maolin2501/A3/el_a3_sdk/README.md

# EL-A3 Python SDK

> 7-DOF 桌面机械臂纯 Python SDK，基于 Direct CAN 通信，支持多臂管理、Pinocchio 动力学、S-curve 轨迹规划。

---

## 文档

| 语言 | 文件 |
|---|---|
| 中文 | [README_zh.md](README_zh.md) |
| English | [README_en.md](README_en.md) |

---

## 快速开始

```bash
# 安装 SDK（开发模式）
cd el_a3_sdk
pip install -e .

# 如需运动学/动力学功能
pip install -e ".[dynamics]"

# 配置 CAN 接口
sudo bash scripts/setup_can.sh can0 1000000

# 运行示例
python3 demo/control_loop_demo.py
python3 demo/zero_torque_mode.py --gravity
```

---

## 项目结构

| 目录/文件 | 说明 |
|---|---|
| `el_a3_sdk/` | Python 包核心代码 |
| `demo/` | 示例脚本 |
| `docs/` | SDK API 协议文档 |
| `resources/` | URDF、Meshes、惯性参数配置 |
| `scripts/` | CAN 配置、测试脚本 |
| `setup.py` | pip 安装配置 |

---

## 依赖

- **必需**: `numpy`, `pyyaml`
- **可选**: `pin` (Pinocchio) - 运动学/动力学

---

## 示例

| 示例 | 说明 |
|---|---|
| `control_loop_demo.py` | 200Hz 控制循环、MoveJ、JointCtrl |
| `xbox_control.py` | Xbox 手柄笛卡尔控制 |
| `zero_torque_mode.py` | 零力矩拖动模式 |
| `dynamics_demo.py` | 重力补偿、雅可比、质量矩阵 |
| `trajectory_demo.py` | S-curve 和样条轨迹规划 |
| `cartesian_control_demo.py` | 笛卡尔空间控制 |
| `motion_control.py` | 路径点运动控制 |
| `waypoint_loop_real.py` | 路径点循环测试 |
| `read_joints.py` | 关节状态读取 |
