maolin2501/A3/el_a3_ros/EDULITE-A3/README.md

# EDULITE-A3

原始 URDF 导出模型文件（PART/STL），供参考使用。

详见项目根目录 [README](../README.md)。
