maolin2501/A3/el_a3_ros/EL_A3_urdf/README.md

# EL_A3_urdf

早期 URDF 版本文件，供参考使用。

当前版本请使用 `el_a3_description/urdf/` 下的 URDF 文件。
