maolin2501/A3/(list of files, cad)

Other CAD files:
el_a3_ros/EL_A3_urdf/EL-A3/meshes/mainlink_back.stl
el_a3_sdk/resources/meshes/mainlink_back.stl
el_a3_sdk/resources/meshes/mainlink_motor.stl
el_a3_ros/EDULITE-A3/meshes/mainlink_motor.stl
el_a3_ros/el_a3_description/meshes/mainlink_motor.stl
el_a3_ros/EL_A3_urdf/EL-A3/meshes/mainlink_motor.stl
el_a3_ros/EDULITE-A3/meshes/mainlink_back.stl
el_a3_ros/el_a3_description/meshes/mainlink_back.stl
el_a3_ros/EDULITE-A3/meshes/l4_l5_link_back.stl
el_a3_ros/el_a3_description/meshes/rack__30_teeth__2.stl
hardware/step/Edulite_A3.step
el_a3_ros/EDULITE-A3/meshes/part_9.stl
el_a3_ros/el_a3_description/meshes/rack_base.stl
el_a3_ros/EL_A3_urdf/EL-A3/meshes/manifold_solid_brep_39_1.stl
el_a3_ros/EDULITE-A3/meshes/6705.stl
el_a3_ros/el_a3_description/meshes/part_8.stl
el_a3_ros/EL_A3_urdf/EL-A3/meshes/hand_r.stl
el_a3_sdk/resources/meshes/small_arm_right.stl
el_a3_ros/el_a3_description/meshes/manifold_solid_brep_40_1.stl
el_a3_ros/EL_A3_urdf/EL-A3/meshes/manifold_solid_brep_40_1.stl
el_a3_sdk/resources/meshes/part_15.stl
el_a3_ros/EDULITE-A3/meshes/part_10.stl
el_a3_ros/el_a3_description/meshes/6705.stl
el_a3_ros/EL_A3_urdf/EL-A3/meshes/l5_shake.stl
el_a3_sdk/resources/meshes/el05.stl
el_a3_ros/EDULITE-A3/meshes/l5_shake.stl
el_a3_ros/el_a3_description/meshes/rack__30_teeth.stl
el_a3_ros/EL_A3_urdf/EL-A3/meshes/part_1.stl
el_a3_sdk/resources/meshes/rack__30_teeth__2.stl
el_a3_ros/EDULITE-A3/meshes/manifold_solid_brep_39_1.stl
el_a3_ros/EL_A3_urdf/EL-A3/meshes/l1_base.stl
el_a3_sdk/resources/meshes/l5_shake.stl
el_a3_ros/EDULITE-A3/meshes/small_arm_right.stl
el_a3_ros/el_a3_description/meshes/l5_shake.stl
el_a3_ros/EL_A3_urdf/EL-A3/meshes/l4_l5_link_back__2.stl
el_a3_sdk/resources/meshes/el05_l5.stl
el_a3_ros/EDULITE-A3/meshes/el05.stl
el_a3_ros/el_a3_description/meshes/l4_l5_link_back__2.stl
el_a3_sdk/resources/meshes/manifold_solid_brep_39_1__2.stl
el_a3_ros/EDULITE-A3/meshes/rack_str.stl
el_a3_ros/el_a3_description/meshes/part_15.stl
el_a3_ros/EL_A3_urdf/EL-A3/meshes/el05.stl
el_a3_sdk/resources/meshes/spur_gear__14_teeth.stl
el_a3_ros/EDULITE-A3/meshes/el05_l4.stl
el_a3_ros/el_a3_description/meshes/manifold_solid_brep_39_1__2.stl
el_a3_ros/EL_A3_urdf/EL-A3/meshes/part_15.stl
el_a3_sdk/resources/meshes/part_8.stl
el_a3_ros/EDULITE-A3/meshes/part_9__2.stl
el_a3_ros/el_a3_description/meshes/part_9.stl
el_a3_ros/EL_A3_urdf/EL-A3/meshes/rack_str.stl
el_a3_sdk/resources/meshes/part_9.stl
el_a3_ros/EDULITE-A3/meshes/rack_base.stl
el_a3_ros/el_a3_description/meshes/rack_str.stl
el_a3_ros/EL_A3_urdf/EL-A3/meshes/part_2.stl
el_a3_sdk/resources/meshes/hand_r.stl
el_a3_ros/el_a3_description/meshes/el05_l4.stl
el_a3_ros/EL_A3_urdf/EL-A3/meshes/l1_link_stop.stl
el_a3_sdk/resources/meshes/el05_l4.stl
el_a3_ros/EDULITE-A3/meshes/manifold_solid_brep_39_1__2.stl
el_a3_ros/el_a3_description/meshes/hand_r.stl
el_a3_ros/EL_A3_urdf/EL-A3/meshes/manifold_solid_brep_39_1__2.stl
el_a3_sdk/resources/meshes/6705__2.stl
el_a3_ros/EDULITE-A3/meshes/hand_r.stl
el_a3_ros/el_a3_description/meshes/manifold_solid_brep_39_1.stl
el_a3_ros/EL_A3_urdf/EL-A3/meshes/el05_l4.stl
el_a3_sdk/resources/meshes/l4_l5_link_back__2.stl
el_a3_ros/EDULITE-A3/meshes/6705__2.stl
el_a3_ros/el_a3_description/meshes/el05.stl
el_a3_ros/EL_A3_urdf/EL-A3/meshes/el05_l5.stl
el_a3_sdk/resources/meshes/6705.stl
el_a3_ros/EDULITE-A3/meshes/rack__30_teeth__2.stl
el_a3_ros/el_a3_description/meshes/part_4.stl
el_a3_ros/EL_A3_urdf/EL-A3/meshes/rack__30_teeth__2.stl
el_a3_sdk/resources/meshes/small_arm_left.stl
el_a3_ros/EDULITE-A3/meshes/spur_gear__14_teeth.stl
el_a3_ros/el_a3_description/meshes/part_9__2.stl
el_a3_ros/EL_A3_urdf/EL-A3/meshes/part_9.stl
el_a3_sdk/resources/meshes/rack__30_teeth.stl
el_a3_ros/EDULITE-A3/meshes/el05_l5.stl
el_a3_ros/EL_A3_urdf/EL-A3/meshes/l2_stop.stl
el_a3_sdk/resources/meshes/rack_str.stl
el_a3_ros/EDULITE-A3/meshes/l4_l5_link_back__2.stl
el_a3_ros/el_a3_description/meshes/part_3.stl
el_a3_ros/EL_A3_urdf/EL-A3/meshes/6705.stl
el_a3_sdk/resources/meshes/l4_l5_link_back.stl
el_a3_ros/EDULITE-A3/meshes/part_3.stl
el_a3_ros/el_a3_description/meshes/l4_l5_link_back.stl
el_a3_ros/EL_A3_urdf/EL-A3/meshes/l4_link_back.stl
el_a3_sdk/resources/meshes/manifold_solid_brep_39_1.stl
el_a3_ros/EDULITE-A3/meshes/part_4.stl
el_a3_ros/el_a3_description/meshes/small_arm_left.stl
el_a3_ros/EL_A3_urdf/EL-A3/meshes/6705__2.stl
el_a3_sdk/resources/meshes/rack_base.stl
el_a3_ros/EDULITE-A3/meshes/rack__30_teeth.stl
el_a3_ros/el_a3_description/meshes/small_arm_right.stl
el_a3_ros/EL_A3_urdf/EL-A3/meshes/l4_l5_link_back.stl
el_a3_sdk/resources/meshes/part_3.stl
el_a3_ros/EDULITE-A3/meshes/manifold_solid_brep_40_1.stl
el_a3_ros/el_a3_description/meshes/part_10.stl
el_a3_ros/EL_A3_urdf/EL-A3/meshes/rack_base.stl
el_a3_sdk/resources/meshes/manifold_solid_brep_40_1.stl
el_a3_ros/EDULITE-A3/meshes/part_8.stl
el_a3_ros/el_a3_description/meshes/spur_gear__14_teeth.stl
el_a3_ros/EL_A3_urdf/EL-A3/meshes/rack__30_teeth.stl
el_a3_sdk/resources/meshes/part_9__2.stl
el_a3_ros/EDULITE-A3/meshes/small_arm_left.stl
el_a3_ros/el_a3_description/meshes/el05_l5.stl
el_a3_ros/EL_A3_urdf/EL-A3/meshes/spur_gear__14_teeth.stl
el_a3_sdk/resources/meshes/part_4.stl
el_a3_ros/EDULITE-A3/meshes/part_15.stl
el_a3_ros/el_a3_description/meshes/6705__2.stl
el_a3_ros/EL_A3_urdf/EL-A3/meshes/l1_link_drv.stl
el_a3_sdk/resources/meshes/part_10.stl
el_a3_ros/EL_A3_urdf/EL-A3/meshes/l4_link_drv.stl
hardware/3mf/Edulite_A3.3mf
