maolin2501/A3/el_a3_ros/XBOX_QUICK_FIX.md

# Xbox手柄快速激活指南

## 🎮 当前情况

您的Xbox手柄显示已通过蓝牙连接，但系统还没有创建输入设备。

## 🔧 快速修复步骤

### 方法1：唤醒手柄（最简单，先试这个）

1. **按住Xbox按钮3秒**（手柄中央的大按钮）
   - 手柄应该震动一下
   - Xbox logo应该变为常亮

2. **按几下其他按钮**
   - 按A、B、X、Y按钮
   - 移动左右摇杆

3. **检查设备**
   ```bash
   ls /dev/input/js*
   ```
   
   如果看到`/dev/input/js0`，成功！跳到"启动控制系统"部分。

### 方法2：重新连接手柄

如果方法1不行，尝试重新连接：

1. **断开手柄**
   - 在蓝牙设置中点击Xbox手柄
   - 选择"断开连接"

2. **重新连接**
   - 按住Xbox按钮
   - 等待自动重新连接
   - 或在蓝牙设置中点击"连接"

3. **检查设备**
   ```bash
   ls /dev/input/js*
   ```

### 方法3：安装专用驱动（最彻底）

如果上述方法都不行，需要安装xpadneo驱动：

```bash
bash ./scripts/install_xpadneo.sh
```

这个驱动专门为蓝牙Xbox手柄设计，安装后：
1. 断开并重新连接手柄
2. 检查设备：`ls /dev/input/js*`

## ✅ 成功标志

当您看到以下输出时，表示成功：

```bash
$ ls /dev/input/js*
/dev/input/js0
```

## 🚀 启动控制系统

一旦手柄设备就绪，运行：

```bash
bash ./scripts/start_xbox_control.sh
```

或手动启动：

```bash
cd ./ros2_ws
source /opt/ros/humble/setup.bash
source install/setup.bash
ros2 launch el_a3_teleop simple_teleop.launch.py
```

## 🧪 测试手柄

### 使用jstest
```bash
jstest /dev/input/js0
```

移动摇杆和按按钮，应该能看到实时数值变化。

### 使用ROS2 joy
```bash
# 终端1
ros2 run joy joy_node

# 终端2
ros2 topic echo /joy
```

## 📱 控制映射

手柄工作后，在RViz中控制机器人：

- **左摇杆**: X/Y平移
- **LT/RT**: Z轴上下
- **右摇杆**: Yaw/Pitch旋转
- **LB/RB**: Roll旋转

## 🔍 调试命令

### 查看所有输入设备
```bash
ls -la /dev/input/
```

### 查看手柄详细信息
```bash
cat /proc/bus/input/devices | grep -A 10 Xbox
```

### 检查蓝牙连接
```bash
bluetoothctl devices
bluetoothctl info | grep -i xbox
```

### 查看系统日志
```bash
dmesg | grep -i "xbox\|input" | tail -20
```

## ⚠️ 常见问题

### Q: 手柄显示已连接但没有/dev/input/js0

**A**: 尝试：
1. 按住Xbox按钮唤醒手柄
2. 移动摇杆激活输入
3. 运行：`sudo modprobe joydev`
4. 安装xpadneo驱动

### Q: 手柄一会儿就断开

**A**: 
- 检查电池电量（当前31%）
- 靠近蓝牙接收器
- 减少2.4GHz干扰源

### Q: 按钮没反应

**A**:
- 确认手柄在ROS2 joy节点中有数据：`ros2 topic echo /joy`
- 检查摇杆死区设置
- 确认launch文件使用了正确的设备路径

## 💡 下一步

1. **首先尝试唤醒手柄**（方法1）
2. **检查设备是否出现**
3. **如果成功，启动控制系统**
4. **如果不成功，尝试方法2或方法3**

---

**准备好后运行**：
```bash
bash ./scripts/start_xbox_control.sh
```
