maolin2501/A3/(list of files, drawings)

Other design files:
hardware/pcb/pcb/EDU_A3_PCB_1_v1.epro
