maolin2501/A3/el_a3_ros/el_a3_moveit_config/config/joint_limits.yaml

# Joint limits for EL-A3 robot arm (Updated for EDULITE-A3)
# Based on motor specifications: RS00 (joints 1-3), EL05 (joints 4-6)
# 
# Note: has_jerk_limits / max_jerk fields are NOT recognized by MoveIt2 and are
# included here only as reference for the hardware interface layer. MoveIt only
# uses has_velocity_limits, has_acceleration_limits, and has_position_limits.

joint_limits:
  L1_joint:
    has_velocity_limits: true
    max_velocity: 33.0  # RS00: 33 rad/s
    has_acceleration_limits: true
    max_acceleration: 20.0
    has_jerk_limits: true
    max_jerk: 50.0  # S-curve jerk limit (rad/s³)
    has_position_limits: true
    min_position: -2.79253
    max_position: 2.79253
    
  L2_joint:
    has_velocity_limits: true
    max_velocity: 33.0  # RS00: 33 rad/s
    has_acceleration_limits: true
    max_acceleration: 20.0
    has_jerk_limits: true
    max_jerk: 50.0
    has_position_limits: true
    min_position: 0.0
    max_position: 3.66519
    
  L3_joint:
    has_velocity_limits: true
    max_velocity: 33.0  # RS00: 33 rad/s
    has_acceleration_limits: true
    max_acceleration: 20.0
    has_jerk_limits: true
    max_jerk: 50.0
    has_position_limits: true
    min_position: -4.01426
    max_position: 0.0
    
  L4_joint:
    has_velocity_limits: true
    max_velocity: 50.0  # EL05: 50 rad/s
    has_acceleration_limits: true
    max_acceleration: 30.0
    has_jerk_limits: true
    max_jerk: 80.0  # Higher jerk for lighter joints
    has_position_limits: true
    min_position: -1.5708
    max_position: 1.5708
    
  L5_joint:
    has_velocity_limits: true
    max_velocity: 50.0  # EL05: 50 rad/s
    has_acceleration_limits: true
    max_acceleration: 30.0
    has_jerk_limits: true
    max_jerk: 80.0
    has_position_limits: true
    min_position: -1.5708
    max_position: 1.5708
    
  L6_joint:
    has_velocity_limits: true
    max_velocity: 50.0  # EL05: 50 rad/s
    has_acceleration_limits: true
    max_acceleration: 30.0
    has_jerk_limits: true
    max_jerk: 80.0
    has_position_limits: true
    min_position: -1.5708
    max_position: 1.5708

  L7_joint:
    has_velocity_limits: true
    max_velocity: 50.0  # EL05: 50 rad/s (Gripper)
    has_acceleration_limits: true
    max_acceleration: 30.0
    has_jerk_limits: true
    max_jerk: 80.0
    has_position_limits: true
    min_position: -1.5708
    max_position: 1.5708
