maolin2501/A3/el_a3_sdk/debugger/widgets/teaching_panel.py

"""示教面板：零力矩模式 + 轨迹录制/回放"""

import math
from PyQt6.QtWidgets import (
    QWidget, QVBoxLayout, QHBoxLayout, QLabel,
    QDoubleSpinBox, QPushButton, QGroupBox,
    QListWidget, QFileDialog, QCheckBox,
)
from PyQt6.QtCore import pyqtSignal, QTimer

from debugger.backend.trajectory_recorder import TrajectoryRecorder


class TeachingPanel(QWidget):
    """示教模式：零力矩拖动 + 轨迹录制回放"""

    zero_torque_requested = pyqtSignal(bool)
    zero_torque_gravity_requested = pyqtSignal(bool)
    move_j_requested = pyqtSignal(list, float)  # positions, duration

    def __init__(self, parent=None):
        super().__init__(parent)
        self.recorder = TrajectoryRecorder(sample_rate_hz=10.0)
        self._zero_torque_active = False
        self._current_positions = [0.0] * 7
        self._init_ui()

    def _init_ui(self):
        layout = QVBoxLayout(self)
        layout.setContentsMargins(4, 4, 4, 4)

        zt_group = QGroupBox("零力矩模式")
        zt_layout = QVBoxLayout()

        self.gravity_check = QCheckBox("启用重力补偿")
        self.gravity_check.setChecked(True)
        zt_layout.addWidget(self.gravity_check)

        self.zt_toggle_btn = QPushButton("开启零力矩")
        self.zt_toggle_btn.setObjectName("enableBtn")
        self.zt_toggle_btn.clicked.connect(self._toggle_zero_torque)
        zt_layout.addWidget(self.zt_toggle_btn)

        zt_group.setLayout(zt_layout)
        layout.addWidget(zt_group)

        rec_group = QGroupBox("轨迹录制")
        rec_layout = QVBoxLayout()

        rate_layout = QHBoxLayout()
        rate_layout.addWidget(QLabel("采样率:"))
        self.rate_spin = QDoubleSpinBox()
        self.rate_spin.setRange(1.0, 50.0)
        self.rate_spin.setValue(10.0)
        self.rate_spin.setSuffix(" Hz")
        rate_layout.addWidget(self.rate_spin)
        rate_layout.addStretch()
        rec_layout.addLayout(rate_layout)

        btn_layout = QHBoxLayout()
        self.rec_btn = QPushButton("开始录制")
        self.rec_btn.clicked.connect(self._toggle_recording)
        btn_layout.addWidget(self.rec_btn)

        self.rec_status = QLabel("未录制")
        btn_layout.addWidget(self.rec_status)
        btn_layout.addStretch()
        rec_layout.addLayout(btn_layout)

        rec_group.setLayout(rec_layout)
        layout.addWidget(rec_group)

        traj_group = QGroupBox("已录制轨迹")
        traj_layout = QVBoxLayout()

        self.traj_list = QListWidget()
        traj_layout.addWidget(self.traj_list)

        traj_btn_layout = QHBoxLayout()
        self.play_btn = QPushButton("回放")
        self.play_btn.clicked.connect(self._playback)
        traj_btn_layout.addWidget(self.play_btn)

        self.save_btn = QPushButton("保存")
        self.save_btn.clicked.connect(self._save_trajectory)
        traj_btn_layout.addWidget(self.save_btn)

        self.load_btn = QPushButton("加载")
        self.load_btn.clicked.connect(self._load_trajectory)
        traj_btn_layout.addWidget(self.load_btn)

        del_btn = QPushButton("删除")
        del_btn.clicked.connect(self._delete_trajectory)
        traj_btn_layout.addWidget(del_btn)

        traj_layout.addLayout(traj_btn_layout)
        traj_group.setLayout(traj_layout)
        layout.addWidget(traj_group)

        self._rec_timer = QTimer(self)
        self._rec_timer.timeout.connect(self._sample_position)

    def _toggle_zero_torque(self):
        self._zero_torque_active = not self._zero_torque_active

        if self._zero_torque_active:
            self.zt_toggle_btn.setText("关闭零力矩")
            self.zt_toggle_btn.setStyleSheet("background-color: #e67e22; color: white;")
            if self.gravity_check.isChecked():
                self.zero_torque_gravity_requested.emit(True)
            else:
                self.zero_torque_requested.emit(True)
        else:
            self.zt_toggle_btn.setText("开启零力矩")
            self.zt_toggle_btn.setStyleSheet("")
            self.zt_toggle_btn.setObjectName("enableBtn")
            if self.gravity_check.isChecked():
                self.zero_torque_gravity_requested.emit(False)
            else:
                self.zero_torque_requested.emit(False)

    def _toggle_recording(self):
        if self.recorder.is_recording:
            traj = self.recorder.stop_recording()
            self._rec_timer.stop()
            self.rec_btn.setText("开始录制")
            if traj:
                self.rec_status.setText(
                    f"录制完成: {traj.num_points}点 / {traj.duration:.1f}s"
                )
                self.traj_list.addItem(
                    f"{traj.name} ({traj.num_points}点, {traj.duration:.1f}s)"
                )
        else:
            self.recorder.sample_rate_hz = self.rate_spin.value()
            self.recorder.start_recording()
            interval_ms = int(1000.0 / self.rate_spin.value())
            self._rec_timer.start(interval_ms)
            self.rec_btn.setText("停止录制")
            self.rec_btn.setStyleSheet("background-color: #e74c3c; color: white;")
            self.rec_status.setText("录制中...")

    def _sample_position(self):
        self.recorder.add_sample(self._current_positions)
        if self.recorder.current_trajectory:
            n = self.recorder.current_trajectory.num_points
            self.rec_status.setText(f"录制中... ({n} 点)")

    def update_positions(self, joint_states):
        self._current_positions = joint_states.to_list(include_gripper=True)

    def _playback(self):
        idx = self.traj_list.currentRow()
        if idx < 0 or idx >= len(self.recorder.trajectories):
            return
        traj = self.recorder.trajectories[idx]
        if not traj.points:
            return
        dt = 1.0 / max(traj.sample_rate_hz, 1.0)
        for pt in traj.points:
            self.move_j_requested.emit(pt.positions[:6], dt)

    def _save_trajectory(self):
        idx = self.traj_list.currentRow()
        if idx < 0 or idx >= len(self.recorder.trajectories):
            return
        traj = self.recorder.trajectories[idx]
        filepath, _ = QFileDialog.getSaveFileName(
            self, "保存轨迹", f"{traj.name}.json", "JSON Files (*.json)"
        )
        if filepath:
            self.recorder.save_trajectory(traj, filepath)

    def _load_trajectory(self):
        filepath, _ = QFileDialog.getOpenFileName(
            self, "加载轨迹", "", "JSON Files (*.json)"
        )
        if filepath:
            traj = self.recorder.load_trajectory(filepath)
            self.traj_list.addItem(
                f"{traj.name} ({traj.num_points}点, {traj.duration:.1f}s)"
            )

    def _delete_trajectory(self):
        idx = self.traj_list.currentRow()
        if idx < 0 or idx >= len(self.recorder.trajectories):
            return
        self.recorder.trajectories.pop(idx)
        self.traj_list.takeItem(idx)
