maolin2501/A3/(commit log)

2026-01-20 feat: 添加S曲线轨迹规划、重力补偿和增强遥控功能
    主要更新:
    - 新增标准7段S曲线轨迹生成器，实现平滑无冲击运动控制
    - 添加关节重力前馈补偿功能，提升运动精度
    - 实现关节软/硬限位保护机制
    - 遥控节点新增X键回零点功能、优化速度控制参数
    - 新增仿真环境Xbox手柄遥控启动文件 (sim_teleop.launch.py)
    - 添加Foxglove Bridge远程可视化服务配置
    - 更新README文档，完善功能说明和参数配置
    [6705.stl, 6705__2.stl, hand_r.stl, joint_limits.yaml, l1_base.stl, l1_link_drv.stl, l1_link_stop.stl, l2_stop.stl]
2026-01-20 feat: 优化手柄控制平滑度，添加加速度限制
    - 添加 max_joint_acceleration 参数 (5.0 rad/s²)
    - 降低 joint_smoothing_alpha 至 0.15 提升平滑效果
    - 降低 max_joint_velocity 至 1.5 rad/s
    - 降低 input_smoothing_factor 至 0.3
    - 调整 position_kp 至 120.0, position_kd 至 2.5
    - 更新 README 添加抖动抑制机制文档
    [rs_a3_ros2_control.xacro]
2026-01-22 添加持续IK计算功能：无手柄输入时也持续计算IK以便调试观察
2026-01-26 feat: 添加 Pinocchio 动力学重力补偿和惯性参数标定
    - 集成 Pinocchio 库实现完整动力学重力补偿 (RNEA 算法)
    - 添加惯性参数自动标定程序 (scripts/inertia_calibration.py)
    - 支持快速/完整/高精度/超高精度四种标定模式
    - 添加零力矩模式 Kd 参数配置
    - 修复标定后惯性参数与旧缩放因子重复应用的问题
    - 更新 README 文档添加 Pinocchio 和标定使用说明
    [rs_a3_ros2_control.xacro]
2026-01-29 feat: 添加RS-A3 Web控制界面
    新增功能:
    - 基于Flask+Three.js的Web控制界面
    - 3D机械臂模型实时可视化
    - 关节状态监控(位置/速度/力矩/温度)
    - 电机使能/失能控制
    - Xbox手柄遥操作支持
    - CAN接口动态配置
    - 温度监控和曲线显示
    - 零力矩模式控制
    - WebSocket实时通信
    技术栈:
    - 后端: Flask + Flask-SocketIO + rclpy
    - 前端: Three.js + Chart.js + Socket.IO
    [6705.stl, 6705__2.stl, hand_r.stl, l1_base.stl, l1_link_drv.stl, l1_link_stop.stl, l2_stop.stl, l4_l5_link_back.stl]
2026-02-02 feat: 更新至EDULITE-A3模型，添加夹爪控制
    - 替换URDF为EDULITE-A3模型
    - 更新所有3D mesh文件
    - 更新关节限位参数
    - 配置电机方向 (L1/L3/L5=-1, L2/L4/L6=+1)
    - 添加夹爪控制 (ID=7, 方向键上下控制±0.4Nm)
    - 完成惯性参数标定 (inertia_params.yaml)
    - 更新README文档
    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
    [6705.stl, 6705__2.stl, joint_limits.yaml, l1_base.stl, l1_link_drv.stl, l1_link_stop.stl, l2_stop.stl, l4_l5_link_back.stl]
2026-02-04 feat: 完善零力矩模式和惯性参数标定
    - 实现关节独立 Kp/Kd 参数支持（零力矩模式）
    - 添加 combo 组合标定模式（L2-L5 联合优化，L6 固定）
    - 更新惯性参数标定结果（RMSE: 0.0793 Nm, R²: 0.9952）
    - 完善 README 文档，添加控制 API 说明
    - 清理 .gitignore，移除构建产物跟踪
    [rs_a3_ros2_control.xacro]
2026-02-04 feat: 添加多机械臂控制支持
    - 添加 URDF prefix 参数支持多机械臂命名空间
    - 创建多臂配置文件 (multi_arm_config.yaml)
    - 创建多臂控制器配置 (multi_arm_controllers.yaml)
    - 创建多臂启动文件 (multi_arm_control.launch.py)
    - 创建主从遥操作节点 (支持一对多、多对多映射)
    - 创建主从配置文件 (master_slave_config.yaml)
    - 添加多 CAN 接口配置脚本 (setup_multi_can.sh)
    - 更新 README 添加多臂控制使用说明
    [multi_arm_controllers.yaml, rs_a3.urdf.xacro, rs_a3_ros2_control.xacro]
2026-02-09 feat: 添加视觉抓取、主从遥操作增强、EDULITE-A3模型和多项改进
    - 添加 rs_a3_vision 视觉抓取包（相机节点、物体检测、手眼标定、视觉伺服）
    - 添加 rs_a3_grasp_gui 抓取GUI包
    - 添加 EDULITE-A3 原始URDF和mesh模型文件
    - 增强主从遥操作节点（多臂支持、配置优化）
    - 更新多臂控制launch和配置（multi_arm_config、controllers）
    - 更新URDF xacro和ros2_control配置
    - 优化硬件接口（零力矩模式服务路径更新）
    - 精简惯性参数标定脚本
    - 添加arm2独立惯性参数配置
    - 添加重力标定工具和分析脚本
    - 添加遥操作和测试脚本
    - 移除已跟踪的__pycac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
    [6705.stl, 6705__2.stl, EDULITE-A3.urdf, hand_eye_calibration.yaml, hand_r.stl, l4_l5_link_back.stl, l4_l5_link_back__2.stl, l5_shake.stl]
2026-02-10 feat: 主从遥操作直接CAN控制、硬件资料目录、README双语更新
    - 从臂(can1) L1-L7全部改为直接CAN MIT控制，无需从臂ros2_control_node
    - 实现关节方向映射(joint→motor坐标转换)，S曲线回零轨迹
    - 从臂跟随参数 Kp=80 Kd=2，50Hz控制频率
    - 主臂Motor 7纯零力矩模式，从臂Motor 7 CAN跟随
    - 新增 hardware/mechanical/ 和 hardware/electronics/ 目录结构
    - README新增主从遥操作章节（中英双语），更新控制映射表和ROS2服务列表
    - 降低CAN驱动调试日志频率，修复服务路径和QoS不匹配问题
    - 移除未使用的 rs_a3_vision 和 rs_a3_grasp_gui 包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
    [hand_eye_calibration.yaml, moveit_servo_config.yaml, multi_arm_controllers.yaml, rs_a3_controllers.yaml, rs_a3_ros2_control.xacro, servo_config.yaml, xbox_servo_teleop.yaml]
2026-02-10 feat: 全面重命名 RS-A3 → EL-A3，RS05 电机型号 → EL05
    - 将所有 RS05 电机型号引用更改为 EL05（代码、配置、文档）
    - 更新 EL05 扭矩映射范围：±5.5Nm → ±6Nm
    - 重命名所有 rs_a3/RS-A3/RS_A3 目录和文件为 el_a3/EL-A3/EL_A3
    - 重命名 rs05*.stl/part 网格文件为 el05*
    - 更新所有文件中的路径引用和包名称
    [6705.stl, 6705__2.stl, EDULITE-A3.urdf, EL-A3.urdf, RS-A3.urdf, el05.stl, el05_l4.stl, el05_l5.stl]
2026-02-25 feat: 更新 PCB 相关文件，精简 electronics 目录结构
    - 添加 Gerber 生产文件 (PCB_1_V1, PCB_2_V1)
    - 添加 PCB 工程原文件 (EDU_A3_PCB_1_v1.epro, EDU_LITE_A3_PCB_2_V1.epro2)
    - 精简 electronics 目录：仅保留 gerber/ 和 pcb/ 两个文件夹
    - 删除空的 bom/、datasheet/、schematic/ 目录
    - 更新 electronics/README.md 目录说明
    - 同步更新项目 README.md
    [EDU_A3_PCB_1_v1.epro]
2026-03-05 feat: 添加 EL-A3 Python SDK、控制参数调优、SDK API 文档
    - 新增 el_a3_sdk 完整 Python SDK（CAN 直连 + ROS Control 双模式）
    - ELA3Interface: CAN 直连控制接口
    - ELA3ROSInterface: ROS2 Control 集成接口
    - ArmManager: 单例多臂管理器
    - ELA3Kinematics: Pinocchio 运动学/动力学
    - 轨迹规划: S-curve 七段式 + 三次样条
    - Web SDK Bridge: REST API + WebSocket 命令桥接
    - 控制参数调优（抑制手柄控制抖动）
    - 全局 Kp: 80→55, Kd: 4→4.5
    - 腕关节 L4-L6 独立 PD: Kp=30, Kd=2
    - 重力补偿比例: 50%→85%
    - 速度前馈 EMA 滤波: alpha 0.08/0.10→0.18/0.18
    - 手柄关节平滑: alpha 0.35→0.25
    - 新增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
    [el_a3.urdf.xacro, el_a3_controllers.yaml, el_a3_ros2_control.xacro, joint_limits.yaml]
2026-03-06 feat: CAN时序优化、位置/速度平滑、IK求解器升级
    硬件层 (el_a3_hardware):
    - CAN sendFrame 重试从10次/1ms降为3次/100us，clock_nanosleep精确延时
    - CAN socket SO_SNDBUF 64KB + Type2 帧过滤，减少ENOBUFS和CPU负载
    - write() 循环时序监控（avg/max/retry统计，每10s输出）
    - debug发布移出关键路径，降频至4-20Hz减少抖动
    - 位置指令启用EMA平滑（smoothing_alpha_=0.2）
    - 速度前馈死区改smoothstep渐变 + 限幅改tanh软饱和
    - Pinocchio重力输入添加独立EMA平滑（α=0.1，~3.4Hz截止）
    - floatToUint16截断改四舍五入消除-0.5LSB系统偏置
    - 新增gravity_input_positions_成员
    - 新增write_timing统计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
2026-03-09 feat: Jacobian微分IK 100Hz控制、硬件平滑优化、时序稳定性提升
    - teleop: 用Jacobian伪逆替代MoveIt异步IK，实现100Hz同步微分IK
    - teleop: 专用控制线程替代rclpy timer，降低时序抖动(±5ms→±3ms)
    - teleop: 2阶临界阻尼滤波器(精确离散解)替代EMA，C1连续输出
    - teleop: 动态dt测量、输入EMA alpha 0.7→0.3、频率50→100Hz
    - hardware: smoothing_alpha 0.08→0.8(近直通)，速度由平滑位置差分导出
    - hardware: debug发布移至独立线程定时器，不阻塞write()热路径
    - hardware: 速度前馈上限 0.3→1.2 rad/s
    - launch: joy autorepeat_rate 20→100Hz，添加wrist_motor_type参数
    - 添加CAN2总线分析测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
    [el_a3.urdf, el_a3_ros2_control.xacro]
2026-03-09 fix: 抑制Jacobian IK高频抖动——增大阻尼、降低滤波omega、添加速度死区
    - Jacobian damping 1e-4 → 1e-3，抑制奇异点附近噪声放大
    - 2阶滤波器 omega 30 → 12，降低截止频率以衰减高频锯齿
    - 添加速度死区（线速 5e-4 m/s，角速 5e-3 rad/s），静止时不积累漂移
    - 输入EMA alpha 0.3 → 0.15，更积极平滑手柄噪声（时间常数~60ms）
    Made-with: Cursor
2026-03-12 feat: SDK零力矩模式逐关节Kd、动力学标定边界修正、el_a3品牌统一
    - 添加 dynamics_calibration.py 逐点增量保存标定脚本
    - 修正 L6_com_z/L3_com_y/L5_mass 优化边界，提升标定精度 (RMSE 0.1037, R²=0.9925)
    - ZeroTorqueModeWithGravity 支持逐关节 Kd 列表
    - 固定质量标定模式 (--fix-masses)
    - el_a3 品牌重命名及文档更新
    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
    [el_a3.urdf, el_a3.urdf.xacro, el_a3_ros2_control.xacro]
2026-03-12 fix: ROS接口命名空间前缀重构、状态机修正、MoveIt可用性日志
    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
2026-03-12 feat: EL-A3 SDK 预览版
    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
2026-03-13 fix: 修复ros2_ws符号链接——补充el_a3_description、改用相对路径、清理旧rs_a3链接
    - 添加缺失的 el_a3_description 符号链接（xacro/MoveIt启动的根本原因）
    - 将 el_a3_hardware、el_a3_moveit_config 从绝对路径改为相对路径
    - 删除已断裂的 rs_a3_description、rs_a3_hardware、rs_a3_moveit_config
    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
2026-03-13 fix: CAN时序精确调度、反馈过期检测、MoveIt交互式标记修复、SDK忙等待优化
    硬件驱动:
    - CAN帧间延迟改为绝对时间调度(TIMER_ABSTIME)，消除sendMotionControl延迟累积
    - 添加电机反馈过期检测(>50ms告警)，及时发现通信中断
    - write() deadline保护，防止控制周期超时
    - 控制周期超标时限幅为2倍标称值而非回退默认值
    - CAN发送缓冲区从64KB缩减至8KB，减少陈旧命令排队
    - CAN发送重试从3次减至2次，重试间隔从100us缩短至50us
    MoveIt配置:
    - demo.launch.py/robot.launch.py: 修复kinematics参数命名空间(robot_description_kinematics)
    - demo.launch.py: 添加world->base_link静态TF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
    [el_a3_ros2_control.xacro]
2026-03-16 feat: ROS QoS可靠性修复、_connected竞态修复、waypoint demo脚本
    - QoS 从 BEST_EFFORT 改为 RELIABLE，depth 1→5，提升轨迹指令可靠性
    - _connected 标志提前至 spin thread 启动前，修复连接状态竞态
    - 新增 waypoint_loop_real/sim、comm_test_rviz demo 脚本
    - 新增 comm_test.launch.py launch 文件
    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
2026-03-16 feat: 添加Docker开发环境（ROS2 Humble headless）
    - 基于 ros:humble-ros-base-jammy 镜像
    - 预装 ros2-control、MoveIt2、Pinocchio、CAN 工具及 Python 依赖
    - docker-compose 配置 host 网络、CAN 设备挂载、FastRTPS no-SHM
    - 源码 volume 挂载，支持容器内 colcon build 开发
    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
2026-03-23 refactor: 重构项目目录——ROS包移至el_a3_ros/、SDK独立化
    - ROS2相关包(description/hardware/moveit/teleop等)统一移至 el_a3_ros/ 子目录
    - el_a3_sdk 重构为独立Python SDK包，新增 el_a3_sdk/ 子模块结构
    - 新增SDK demo: control_loop_demo、xbox_control
    - 移除根目录冗余文档(README_en/README_zh等)，更新顶层README
    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
    [6705.stl, 6705__2.stl, EDULITE-A3.urdf, EDU_A3_PCB_1_v1.epro, EL-A3.urdf, el05.stl, el05_l4.stl, el05_l5.stl]
2026-03-24 feat: STL模型LFS迁移、SDK/ROS接口更新、硬件设计资料及测试脚本
    - 添加 .gitattributes，配置 STL/STEP/PDF/Gerber 等二进制文件使用 Git LFS
    - STL 网格文件迁移至 LFS 指针（el_a3_ros、el_a3_sdk）
    - SDK: interface.py 接口更新、xbox_control/zero_torque_mode demo 改进
    - ROS: 控制器参数、launch 文件、URDF xacro、MoveIt 配置更新
    - 新增 hardware/ 目录：机械结构(STEP/3MF)、PCB 电路板、接线说明
    - 新增 SDK 基础测试脚本（connection/motion/cartesian/multi_arm/params/zero_torque）
    - 新增 ROS startup_test_demo、英文 README、硬件接口文档
    - 移除 el_a3_ros 下旧版 hardware 占位文件和 rs_a3_hardware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
    [6705.stl, 6705__2.stl, EDU_A3_PCB_1_v1.epro, Edulite_A3.3mf, Edulite_A3.step, el05.stl, el05_l4.stl, el05_l5.stl]
2026-03-26 feat: SDK debugger GUI、joystick模块、RS05动力学配置、轨迹规划增强
    - 新增 debugger/ 上位机调试GUI（关节控制、示教、游戏手柄、3D可视化等面板）
    - 新增 joystick.py 手柄输入模块
    - 提取 EDULITE/main 重力补偿动力学文件至 resources/rs05/（URDF + 惯量标定参数）
    - 增强 trajectory.py 轨迹规划（新增样条插值等）
    - 更新 interface.py 接口、xbox_control.py demo、setup.py 依赖
    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
    [el_a3.urdf]
2026-03-26 chore: 移除EDULITE合并引入的303个冗余文件
    清理合并EDULITE Initial commit时引入的旧结构文件，
    使main分支与feature/el-a3-sdk目录结构一致：
    - 移除 EDULITE-A3/（原始URDF导出模型）
    - 移除 EL_A3_urdf/（早期URDF版本）
    - 移除根级 el_a3_description/、el_a3_hardware/、el_a3_moveit_config/（已迁移至el_a3_ros/）
    - 移除根级 ros2_ws/、scripts/、hardware/（已迁移至el_a3_ros/）
    - 移除根级 Xbox/蓝牙文档、电机协议文档、frames文件
    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
    [6705.stl, 6705__2.stl, EDULITE-A3.urdf, EDU_A3_PCB_1_v1.epro, EL-A3.urdf, el05.stl, el05_l4.stl, el05_l5.stl]
